dylancunliffe/doppler-speed-radar/README.md

Please see https://dylancunliffe.github.io/2026-03-05-doppler-speed-radar/ for more information.

## Overview

Measuring the speed of moving objects using a 10.525 GHz X-band radar module is fundamentally a mixed-signal hardware challenge. The radar transceiver outputs a raw Intermediate Frequency (IF) signal based on the Doppler shift. For standard speeds (0–100 MPH), this frequency shift sits squarely in the low audio range (tens of Hertz to a few kilohertz), but the amplitude is exceptionally weak—often in the microvolt range.

The objective of this project was to design a custom PCB from the ground up that could extract, cleanly amplify, and digitize this fragile analog sine wave while operating right next to a high-speed, noisy microcontroller.

To accomplish this, I engineered a complete hardware and firmware system:
- A **4-layer mixed-signal PCB** designed in Altium Designer.
- An **active analog signal chain** simulated in LTspice utilizing rail-to-rail op-amps.
- A **linear power distribution network** dropping a 7.4V Li-ion source to a stable 3.3V logic rail.
- **Bare-metal C firmware** on an STM32G4 to sample the waveform, calculate velocity via DSP, and drive an OLED display.

### System Flow
1. **Radar Module** emits 10.5 GHz wave and outputs the low-frequency IF Doppler shift.
2. **Active Filter Stage** removes high-frequency noise and applies ~175x AC gain.
3. **STM32G4 ADC** samples the amplified 0–3.3V analog waveform.
4. **CMSIS-DSP Pipeline** executes a Fast Fourier Transform (FFT) on a continuous DMA buffer to isolate the dominant Doppler frequency..
5. **Velocity Math** converts frequency to speed ($f_d = 2 v f_0 / c$).
6. **OLED Display** updates the real-time speed via I2C.

---

## Analog Front-End & Filter Design

Because the STM32 operates on a single 3.3V supply, standard dual-supply op-amps could not be used. I selected the **MCP6002**, a CMOS rail-to-rail operational amplifier. To center the AC radar wave within the 0V to 3.3V window of the STM32's ADC, the signal chain utilizes a 1.65V virtual ground generated by a bypassed resistor divider.

### The DC Saturation Challenge
During the initial schematic design, the amplifier was configured in a standard non-inverting topology with a gain of ~175. However, this introduced a critical mathematical flaw: the 1.65V DC bias was being fed directly into the non-inverting input. 

If uncorrected, the op-amp would apply the 175x multiplier to the DC bias as well ($1.65V \times 175 = 288V$). Constrained by the physical 3.3V power rails, the op-amp's output transistors would immediately slam completely open, permanently saturating the output at 3.3V and erasing the AC radar signal entirely.

**The Fix:** I decoupled the DC and AC gain by inserting `4.7 µF` blocking capacitors into the ground legs of the gain resistors. Because DC current cannot physically bridge a capacitor's plates, the DC gain defaulted to exactly 1 (passing the 1.65V bias cleanly), while the oscillating AC radar wave passed through the capacitors to receive the full 175x amplification.

*Note: The feedback network also utilizes a 270 pF capacitor in parallel with a 174 kΩ resistor, forming a low-pass filter with a cutoff frequency of roughly 3.4 kHz. This physically blocks high-frequency environmental noise, optimizing the board for measuring speeds up to ~110 MPH.*
---

## PCB Floorplanning & Signal Integrity

Drawing the schematic is only half the battle; the physical geometry of the copper dictates whether the board will actually function. I opted for a **4-layer stackup** (Top Signal, Internal Ground, Internal 3.3V, Bottom Signal). 

At high frequencies (like the STM32's 170 MHz internal clock), return current takes the path of least *inductance*, mirroring the signal trace directly underneath it. The solid, unbroken internal Ground plane ensures pristine return paths and minimizes electromagnetic interference (EMI).

### Floorplanning Architecture
- **The Analog Island:** The MCP6002 (SOIC-8 package) and its passive filter components are tightly clustered in the bottom-left quadrant of the board. Keeping these traces as short as possible prevents them from acting as antennas that pick up digital switching noise.
- **Digital Separation:** High-speed communication lines (I2C for the display, UART for telemetry) were routed to physically adjacent Alternate Function (AF) pins on the opposite side of the STM32 package, ensuring digital traces never cross into the analog domain.
- **Decoupling Geometry:** The `0.1 µF` decoupling capacitors were placed essentially touching the STM32's VDD and VDDA pins. Minimizing this physical distance is critical to reducing parasitic trace inductance, ensuring the microcontroller receives instantaneous current during high-frequency clock ticks.
---

## Firmware & Digital Signal Processing

With the hardware outputting a clean 0-3.3V analog wave, the firmware utilizes the STM32's high-speed ADC to sample the signal.

### Example DSP Snippet
Rather than blocking the CPU to read every individual voltage point, the ADC is configured to use Direct Memory Access (DMA) to continuously fill a buffer in the background. Once the buffer is full, a zero-crossing algorithm (or FFT) determines the dominant frequency.

Once the frequency is isolated, the firmware applies the Doppler equation to calculate velocity and pushes the formatted integer to the I2C OLED display.

---

## Hardware Bring-Up & Validation

Physical testing was conducted to validate the analog and power stages before the microcontroller was programmed.

1. **Power Integrity:** Verified the AP7375 (5V) and LP5907 (3.3V) linear regulators were outputting stable voltage under load, ensuring the battery pack's 7.4V input was efficiently stepped down without switching noise.
2. **Signal Chain Staging:** Used an oscilloscope to inject a test sine wave and verified the 1.65V DC offset was stable and the AC gain was accurately multiplying the signal without clipping against the rails.
   
---

## Future Revisions

While the current architecture successfully isolates the analog signal and processes velocity, future revisions of this hardware could explore:
- **Active Shielding:** Routing a dedicated ground guard ring around the high-impedance op-amp inputs to further suppress leakage currents and EMI.
- **Moving Target Indication (MTI):** Implementing a digital high-pass DC-blocking filter in firmware to aggressively reject stationary clutter (0 Hz bins) before the FFT stage, increasing the signal-to-noise ratio for moving targets.
- **Gain Staging:** Splitting the 175x gain across three op-amp stages rather than two to increase the overall bandwidth, allowing the radar to track objects moving at much higher velocities without attenuation.
