dylancunliffe/doppler-speed-radar/(list of files, drawings)

Other design files:
manufacturing/DVM1.PcbDoc
manufacturing/DVM1.SchDoc
