dylancunliffe/doppler-speed-radar/main.c

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
/* Includes ------------------------------------------------------------------*/
#include "main.h"

/* USER CODE BEGIN Includes */
#include "arm_math.h"
#include <stdio.h>
/* USER CODE END Includes */

/* USER CODE BEGIN PD */
#define ARM_MATH_CM4

#define c 299792458.0f // m/s

// CHANGE 0x30 ADDRESS TO WHATEVER THE EFM* ADD IS
#define EFM8_I2C_ADDR (0x30 << 1)

/* USER CODE END PD */

ADC_HandleTypeDef hadc1;
DMA_HandleTypeDef hdma_adc1;

I2C_HandleTypeDef hi2c1;

TIM_HandleTypeDef htim6;

/* USER CODE BEGIN PV */
volatile uint8_t uart_tx_buffer[2] = {0,0};
/* USER CODE END PV */

void SystemClock_Config(void);
static void MX_GPIO_Init(void);
static void MX_DMA_Init(void);
static void MX_ADC1_Init(void);
static void MX_TIM6_Init(void);
static void MX_I2C1_Init(void);
/* USER CODE BEGIN 0 */
uint16_t ADC_BUFFER[2048];

float32_t ADC_FLOAT[1024];
float32_t fft_output[1024];
float32_t fft_mag[512];
volatile float32_t max_mag;
volatile uint32_t max_mag_index;

volatile uint8_t data_ready_flag = 0;
uint16_t *current_buffer_ptr;

arm_rfft_fast_instance_f32 S;

volatile float32_t velocity;

uint32_t printf_tim_count = 0;
uint8_t enable = 1;

/* USER CODE END 0 */

/**
  * @brief  The application entry point.
  * @retval int
  */
int main(void)
{

  /* MCU Configuration--------------------------------------------------------*/

  /* Reset of all peripherals, Initializes the Flash interface and the Systick. */
  HAL_Init();

  /* Configure the system clock */
  SystemClock_Config();

  /* Initialize all configured peripherals */
  MX_GPIO_Init();
  MX_DMA_Init();
  MX_ADC1_Init();
  MX_TIM6_Init();
  MX_I2C1_Init();
  /* USER CODE BEGIN 2 */
  arm_status init_status = arm_rfft_fast_init_f32(&S, 1024);
  if (init_status != ARM_MATH_SUCCESS) {
      while(1); // If the code gets stuck here the macros failed
  }
  HAL_ADC_Start_DMA(&hadc1, (uint32_t*)ADC_BUFFER, 2048);
  HAL_TIM_Base_Start(&htim6);

  /* USER CODE END 2 */

  /* Infinite loop */
  /* USER CODE BEGIN WHILE */

  while (1)
  {
	  // check enable pin state
	          if (HAL_GPIO_ReadPin(ENABLE_PIN_GPIO_Port, ENABLE_PIN_Pin) == GPIO_PIN_RESET) {
	        	  HAL_GPIO_WritePin(LED2_GPIO_Port, LED2_Pin, SET);
	              // if enable turned on, but hardware is off
	              if (enable == 0) {
	                  HAL_ADC_Start_DMA(&hadc1, (uint32_t*)ADC_BUFFER, 2048);
	                  HAL_TIM_Base_Start(&htim6);
	                  enable = 1;
	              }

				  if(data_ready_flag != 0){
					  if(data_ready_flag == 1){
						  current_buffer_ptr = &ADC_BUFFER[0];
					  }
					  if(data_ready_flag == 2){
						  current_buffer_ptr = &ADC_BUFFER[1024];
					  }
					  for(int i = 0; i < 1024; i++){
						  ADC_FLOAT[i] = (float32_t)current_buffer_ptr[i]; // Convert to float
						  ADC_FLOAT[i] -= 2048.0f; // Deal with DC offset
					  }

					  arm_rfft_fast_f32(&S, ADC_FLOAT, fft_output, 0); // Forward FFT
					  arm_cmplx_mag_f32(fft_output, fft_mag, 512); // Calculate magnitudes of the complex frequencies

					  arm_max_f32(&fft_mag[5], 512 - 5, &max_mag, &max_mag_index); // findmax

					  // Calculate the velocity
					  if(max_mag > 20000.0f) {
						  velocity = c * ((max_mag_index + 5.0f) * (10000.0f / 1024.0f)) / (2.0f * 10.525e9f);
						  velocity *= 3.6f;
					  }
					  else {
						  velocity = 0.0f;
					  }

					  data_ready_flag = 0;

					  // Scale float to maintain decimal point
					  uint16_t velocity_int = (uint16_t)(velocity * 10.0f);
				  }

	          }
	          else {
	                  // Shutdown hardware if enable pin is low
	                  HAL_GPIO_WritePin(LED2_GPIO_Port, LED2_Pin, RESET);
	                  if (enable == 1) {
	                      HAL_ADC_Stop_DMA(&hadc1);
	                      HAL_TIM_Base_Stop(&htim6);
	                      data_ready_flag = 0; // Clear any pending flags
	                      enable = 0;
	                  }
	              }

    /* USER CODE END WHILE */

    /* USER CODE BEGIN 3 */
  }
  /* USER CODE END 3 */
}

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
/* USER CODE BEGIN 4 */
// This fires when the buffer is HALF full (index 1023)
void HAL_ADC_ConvHalfCpltCallback(ADC_HandleTypeDef* hadc) {
    data_ready_flag = 1;
}

// This fires when the buffer is TOTALLY full (index 2047)
void HAL_ADC_ConvCpltCallback(ADC_HandleTypeDef* hadc) {
    data_ready_flag = 2;
}
/* USER CODE END 4 */
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
