dylancunliffe/doppler-speed-radar/(notices)

Notices in the files:
includes/main.h:
Copyright (c) 2026 STMicroelectronics.
All rights reserved.
This software is licensed under terms that can be found in the LICENSE file
